domebevi/BalanceBOT.Self-Balancing_Robot/README.md

# Self-Balancing Real-time Sensing Robot

University Project (Politecnico di Bari)  
  
Self-balancing 2-wheels robot, with stepper motors controlled by ArduinoUno board.  
Features: PID-control logic, Kalman filter,  Bluetooth two-ways comunication, and real-time sensor data graphical representation.

<a href="FINAL_REPORT.pdf" target="_blank">Final Report</a> - <a href="https://youtube.com/shorts/gR7PDAymfLc?si=TlCTKDoYQ1yhZOqR">Video</a>

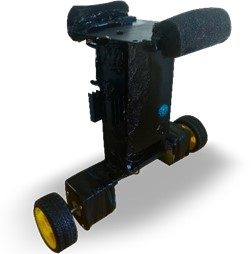
[picture p1: image.jpg]

  
Credits: Domenico Bevilacqua - domebevi@gmail.com
